nicolasvargaszz/Embedded-systems/image/componentes2.jpeg

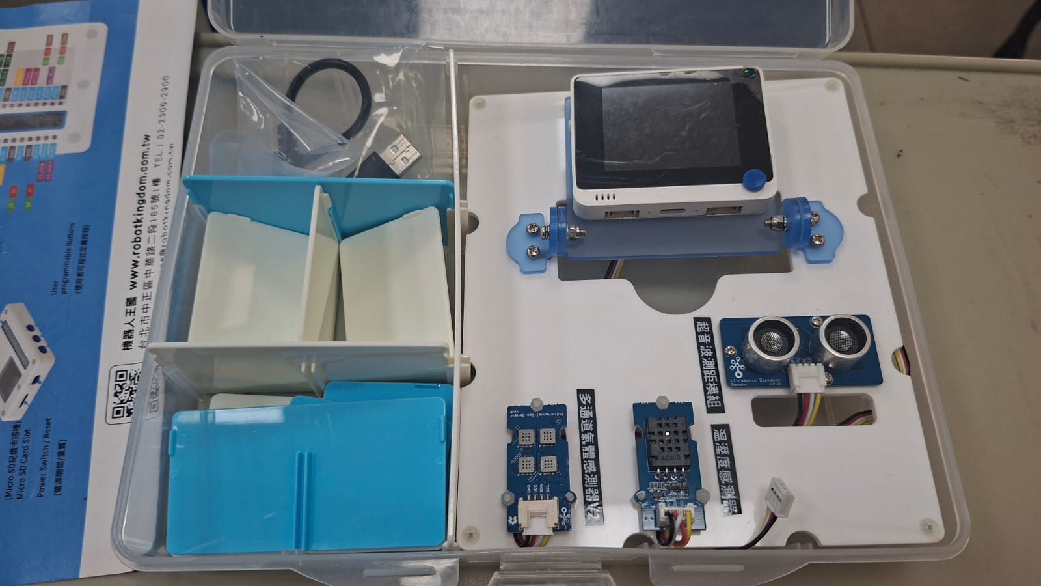
image/componentes2.jpeg
