nicolasvargaszz/Embedded-systems/image/componentes.jpeg

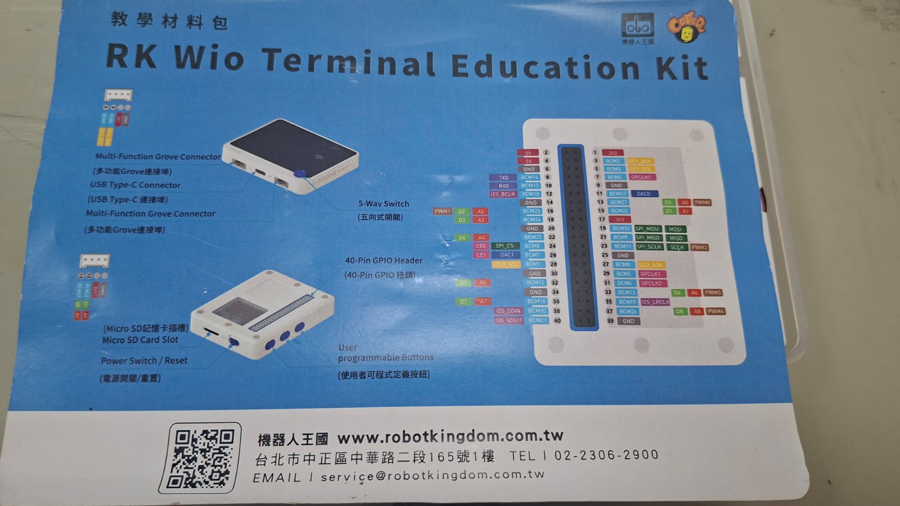
image/componentes.jpeg
