nicolasvargaszz/Embedded-systems/image/equipo.jpeg

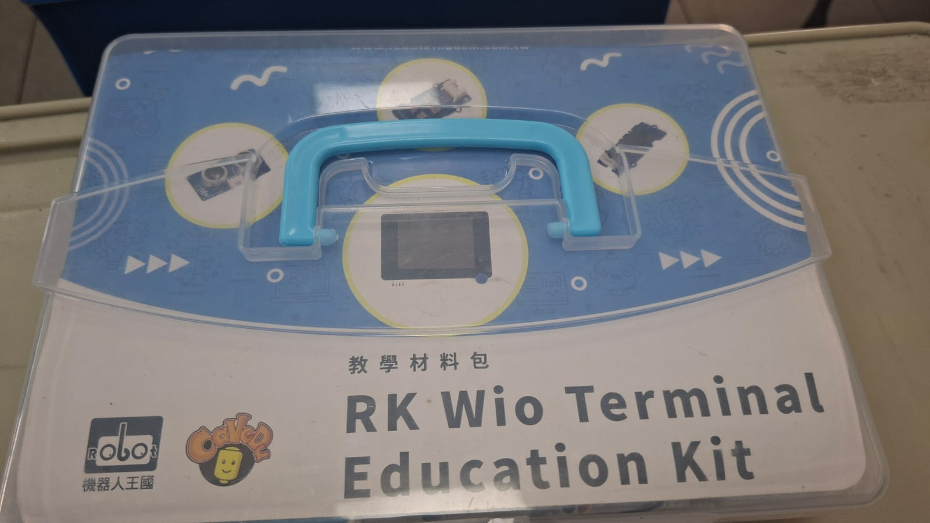
image/equipo.jpeg
