nicolasvargaszz/Embedded-systems/GymCoachIA/firmware/XiaoBridge/secrets.h

#pragma once
// Fill these locally. Do not publish a populated secrets.h.
#define BLYNK_TEMPLATE_ID "TMPL_REPLACE_ME"
#define BLYNK_TEMPLATE_NAME "Gym Coach IA"
#define BLYNK_AUTH_TOKEN ""
static const char WIFI_SSID[] = "";
static const char WIFI_PASSWORD[] = "";
