nicolasvargaszz/Embedded-systems/(commit log)

2026-10-25 Notas del proyecto y .gitignore
    CLAUDE.md junta la configuracion del hardware y las trampas conocidas (Servo en SAMD51, SSCMA, Wi-Fi 2.4 GHz, LED RGB de anodo comun). El documento del curso y los proyectos de otros anios quedan fuera del repo.
2026-10-25 Checkpoints de clase y tareas HW1/HW2
    Servo, microfono, DHT20, LED RGB, homework1 y el clasificador de gestos con sensor de luz (hw2_gestos).
2026-10-25 Prueba Vision AI V2 -> Wio por I2C
    Muestra la camara y las detecciones en el LCD del Wio Terminal (buffer rx de 32 KB para que no se corten las respuestas).
2026-10-25 Guia del proyecto Gym Coach IA y fotos del kit
    Guia completa (hardware, conexiones, dataset, plan) y la tarjeta de pines del Wio.
2026-10-25 Modelo de pose YOLOv8n-pose 256 para la Vision AI V2
    Build de Himax; se carga con SenseCraft Workspace -> Upload Model. SenseCraft no trae un modelo de pose para esta placa.
2026-10-25 Grabador de datos en la compu (coach_pc.py)
    Lee la Vision AI por USB, dibuja el esqueleto, calcula codo/rodilla/cadera/torso, cuenta reps y graba muestras de 10 s a 10 Hz en formato Edge Impulse (modo guiado con voz).
    Ahora corre en macOS, Windows y Linux: detecta el puerto solo, la voz usa say o SAPI y si no hay se imprime, pide el nombre de la persona, permite fijar el lado (--lado) y avisa cuando un angulo casi no se vio.
2026-10-25 Primeras 12 muestras (nico): curl, sentadilla, descanso
    4 de cada etiqueta, 10 s a 10 Hz. curl.nico_003 es floja (se tomo el brazo equivocado).
2026-10-25 Firmware GymCoachIA para el Wio Terminal
    Codigo del equipo: conteo de reps con maquina de estados, reglas de tecnica, salidas (TM1637, RGB, LEDs, servo, buzzer), adaptador de Edge Impulse, grabador por USB y puente XIAO -> Blynk. Incluye tests y scripts de instalacion/compilacion aislados.
    secrets.h va con valores vacios para que compile; no subir credenciales reales.
    [CoachCore.h, EIAdapter.h, Outputs.h, Settings.h, Uplink.h, Vision.h, WioCoach.ino, XiaoBridge.ino]
2026-10-25 README con guia rapida para grabar datos
    Paso a paso para Mac y Windows: instalar, grabar curls y sentadillas con coach_pc.py, como pararse frente a la camara y como compartir los datos (repo o Edge Impulse).
2026-10-25 Instalar el modelo de Edge Impulse con un comando
    tools/install_ei.py instala el ZIP de Edge Impulse en .arduino/, borra la carpeta espressif del SDK y genera ei_model.h con el header real del modelo. build.py wio --ei activa el modo AUTO. Probado con un export simulado: compila y pasan los static_assert (80 entradas, 4 etiquetas, 10 Hz).
2026-10-25 Wio: no bloquear series nuevas sin el XIAO
    Sin XIAO nadie confirma los resumenes y la cola se llenaba a las 8 series, trabando el Wio hasta reiniciar. Ahora se descarta el resumen mas viejo.
2026-10-25 Modo guiado con extension y pasos para entrenar y cargar el modelo
    El clasificador del Wio exige las 4 etiquetas, asi que el modo guiado ahora tambien pide extension. El README explica como subir los datos a Edge Impulse, la configuracion del impulse (2000 ms, 500 ms, 10 Hz, Flatten + Classification) y como cargarlo al Wio.
2026-10-25 coach_pc: avisar cuando la camara no responde
    Si la Vision AI reporta Fail:-60 (cinta de la camara floja) se avisa en la terminal, y una SerialException muestra el error real en vez de asumir que se desenchufo el USB.
    [coach_pc.py]
2026-10-25 Datos de mathias: 8 muestras de curl, sentadilla, extension y descanso
    32 muestras de 10 s a 10 Hz, lado izquierdo. sentadilla.mathias_007 tuvo codo, cadera y torso poco visibles (rellenados): mejor no usarla para entrenar.
2026-10-26 Wio: clasificación en vivo con el modelo de EI y prueba guiada con voz
    - Resampler: tolera 500 ms entre cuadros (por Grove llegan cada ~300 ms y la
    ventana de 2 s nunca se llenaba).
    - EI: saltea cuadros con una articulación faltante en vez de reiniciar la
    ventana, decide cada 200 ms, corre siempre y muestra NOW: <ejercicio> en el LCD.
    - Imprime las 4 probabilidades por serie (# ei ...).
    - tools/probar_modelo.py: prueba guiada con cuenta regresiva, y --en-vivo que
    anuncia el ejercicio en inglés.
2026-10-26 Datos: más series de nico, sebastian y mathias (de costado y de frente)
2026-10-26 Circuito en vivo, vista de cámara y referencia para el mid demo
    - RGB y barra de LEDs siguen al clasificador fuera de una serie (azul descanso,
    verde ejercicio; la barra muestra la profundidad del movimiento).
    - CAM 1: el Wio manda keypoints y JPEG por USB; probar_modelo.py --camara los muestra.
    - Resampler tolera 1 s entre cuadros (con imagen llegan cada ~650 ms).
    - Firmware del demo sin servo (colgaba el Wio).
    - proyecto/midterm_referencia.md: base para el documento y las slides.
2026-10-26 Estado real del mid demo: sin servo, display ni XIAO; guion corregido
2026-10-26 probar_modelo: saltear cuadros vacíos de la cámara en vez de cortar
2026-10-26 Panel en vivo en la compu: ejercicio, reps, ángulos y sesión en CSV
2026-10-26 Panel: avisar qué parte del cuerpo no ve la cámara y cómo iniciar el conteo
2026-10-26 Contador grande en el Wio y estado de la serie en el panel
    El Wio informa por USB si está contando y qué ejercicio fijó AUTO;
    el panel lo muestra para que no parezca que no cuenta.
2026-10-26 Contador de reps: funciona a la velocidad real del Grove (~3 fps)
    El contador se reiniciaba en cada cuadro porque tomaba como pérdida de
    seguimiento cualquier hueco de más de 300 ms, y por I2C los cuadros llegan
    cada 300-650 ms. Ahora el margen es 1 s, la posición de inicio tolera 10°
    y el suavizado usa 2 cuadros en vez de 3 (con 3 recortaba el fondo de la
    rep). En AUTO la serie sigue al clasificador si cambia de ejercicio.
    Test nuevo con cuadros cada 450 ms.
2026-10-26 Contador menos exigente: umbrales para ~3 fps
    Rep válida desde 0,7 s (antes 1 s); curl hasta 70° y vuelta a 130°,
    sentadilla hasta 115° y vuelta a 155°, extensión hasta 145° y vuelta a 120°.
    A esta velocidad la cámara suele perderse el cuadro más profundo.
2026-10-26 Contador mucho más tolerante para una cámara de ~3 fps
    Rep válida desde 0,5 s; curl hasta 90°/vuelta 120°, sentadilla 135°/145°,
    extensión 135°/130°. La profundidad se mide con el cuadro crudo más profundo
    (uno solo alcanza), no con el promedio.
